konradgiero/MPPT/Dokumentacja/MPPT - Power Stage.docx

PROJEKT UKŁADU MOCY MPPT

1. PANELE SOLARNE

Jiangsu Sunport Power Co., Ltd – Benchmark II SPP310M60S

Specyfikacja:

- Maximum Power (Pmax): 310 W,
- Voltage at Maximum Power (Vmpp): 32,8 V
- Current at Maximum Power (Impp): 9,45 A
- Open Circuit Voltage (Voc): 39,9 V
- Short Circuit Current (Isc): 9,81 A
- Efficiency: 18,9 %
- Weight: 4 kg
- Dimensions: 1,66x0,99

Series Fuse Rating 15 A.

Powierzchnia: 3,2 m2

Solbian SP 144

Specyfikacja:

- Maximum Power (Pmax): 144 W,
- Voltage at Maximum Power (Vmpp): 25,3 V,
- Current at Maximum Power (Impp): 5,7 A,
- Open Circuit Voltage (Voc): 30 V,
- Short Circuit Current: 6 A,
- Weight: 1,9 kg,
- Dimensions: 1,49 x0,55

Powierzchnia: 0,82

2. NAPIĘCIA I PRĄDY WEJŚCIOWE

V_(IN(max)) =80 V

V_(IN(min)) =20 V

V_(OUT(max)) =120 V

V_(OUT(min)) =80 V

3. MAKSYMALNY PRĄD PRZEŁĄCZANIA

Panele elastyczne firmy Benchmark II SPP315M60S osiągają prąd zwarcia równy 10 A. Stąd wiemy, że maksymalny prąd cewki wynosi 10 A.

4. WARTOŚĆ INDUKCJI CEWKI

Im niższa wartość indukcji tym mniejszy rdzeń. Odpowiednią wartość indukcji obliczamy na podstawie poniższego wzoru:

ΔI_L (0.2 do 0.4)⋅I_(OUT(max)) ⋅(V_(OUT))/(V_(IN))

ΔI_L =(0.2 do 0.4)⋅9,45 A⋅(120 V)/(32,8 V)=(0.2 do 0.4)⋅34,5732 A

f_s =100 kHz

L=(V_(IN) (V_(OUT) -V_(IN) ))/(ΔI_L f_s V_(OUT))

L=(80 V(120 V-80 V))/(ΔI_L ⋅100000 Hz⋅120V)= (266,67 uH)/(ΔI_L)

Dobieramy wartość indukcji równą L=150 uH

5. GRUBOŚĆ UZWOJENIA

Maksymalny prąd cewki zakładamy 20 A. Wykorzystamy Lice nawojową w bawełnie 300x,01, średnica 2,5 mm, prąd 23 A.

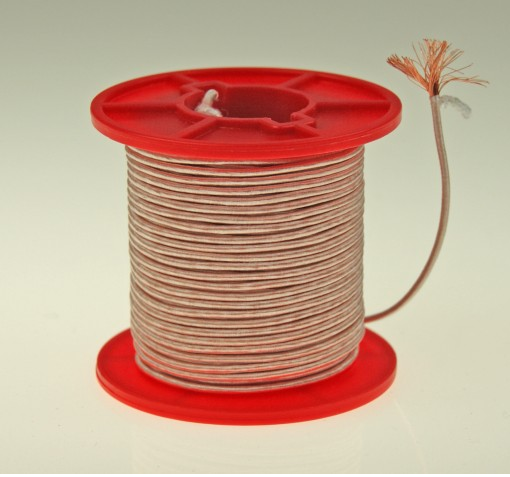
[picture p1: figure]

Rys. 5.1 Lica nawojowa

6. WZORY

W celu wyznaczenia odpowiedniego rdzenia wykorzystamy poniższe wzory.

L=A_l ⋅N^2

Prawo Ampera:

Hl=ni

H=(ni)/l

Gęstość strumienia magnetycznego:

B=(u_0 u_e ni)/l

7. RDZEŃ

Wykorzystana dwa rdzenie typu E42/21/20, jeden z gap 0 mm (B66329GX187) i drugi 1,5 mm (B66329G1500X187). Owinięto 22 razy licą i uzyskano następujące parametry statyczne:

- indukcyjność L = 102,6 uH,
- impedancja Z = 0,647 przy 1 kHz, Z = 0,0247 przy 120 Hz.
8. ZASILANIE

Załącza się przy 8,3 V i wyłącza 8,0 V -> dolny próg

Wyłącza się przy 14,4 V, załącza się przy 13,5V -> górny próg
