konradgiero/MPPT/Eagle/scheme.pdf

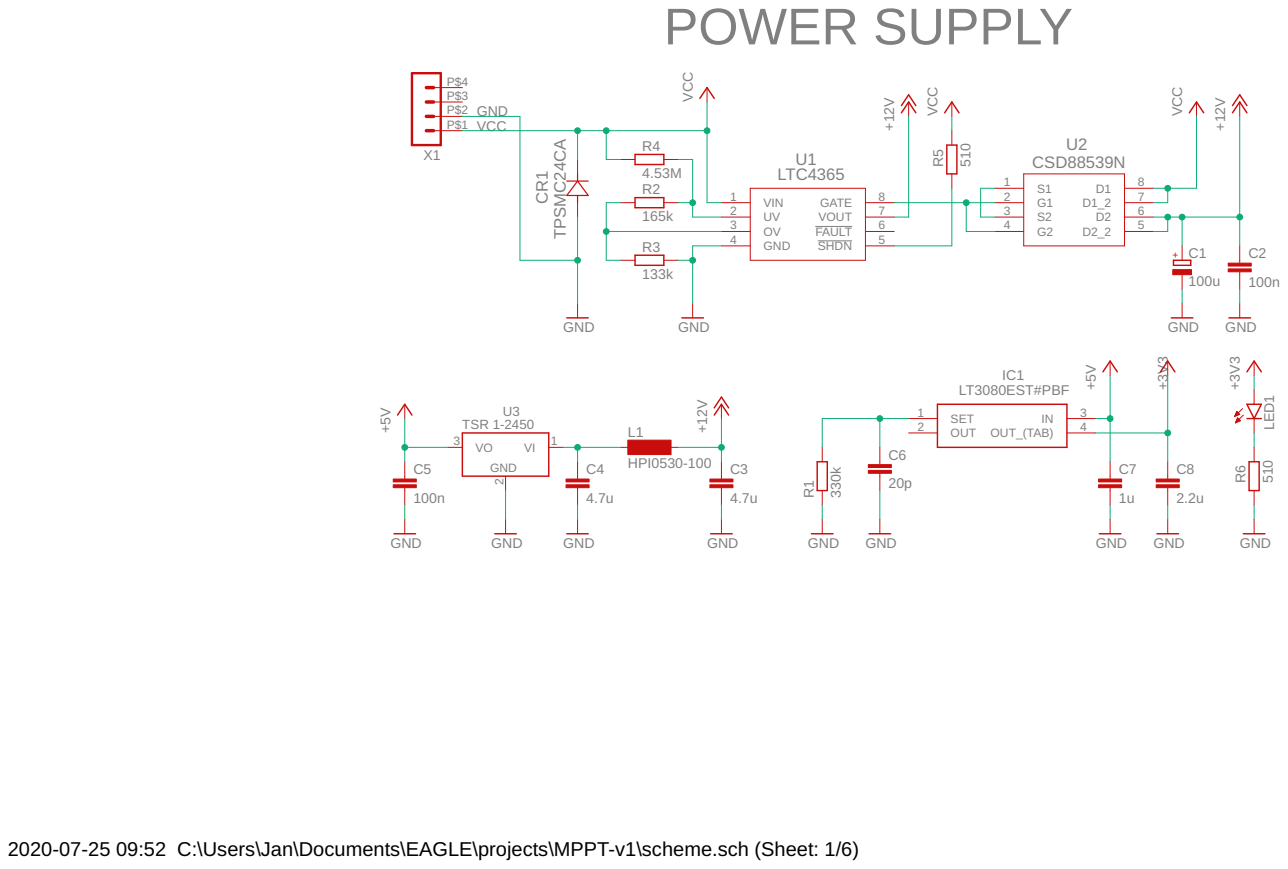
[picture p4: page 1]

2020-07-25 09:52 C:\Users\Jan\Documents\EAGLE\projects\MPPT-v1\scheme.sch (Sheet: 1/6)

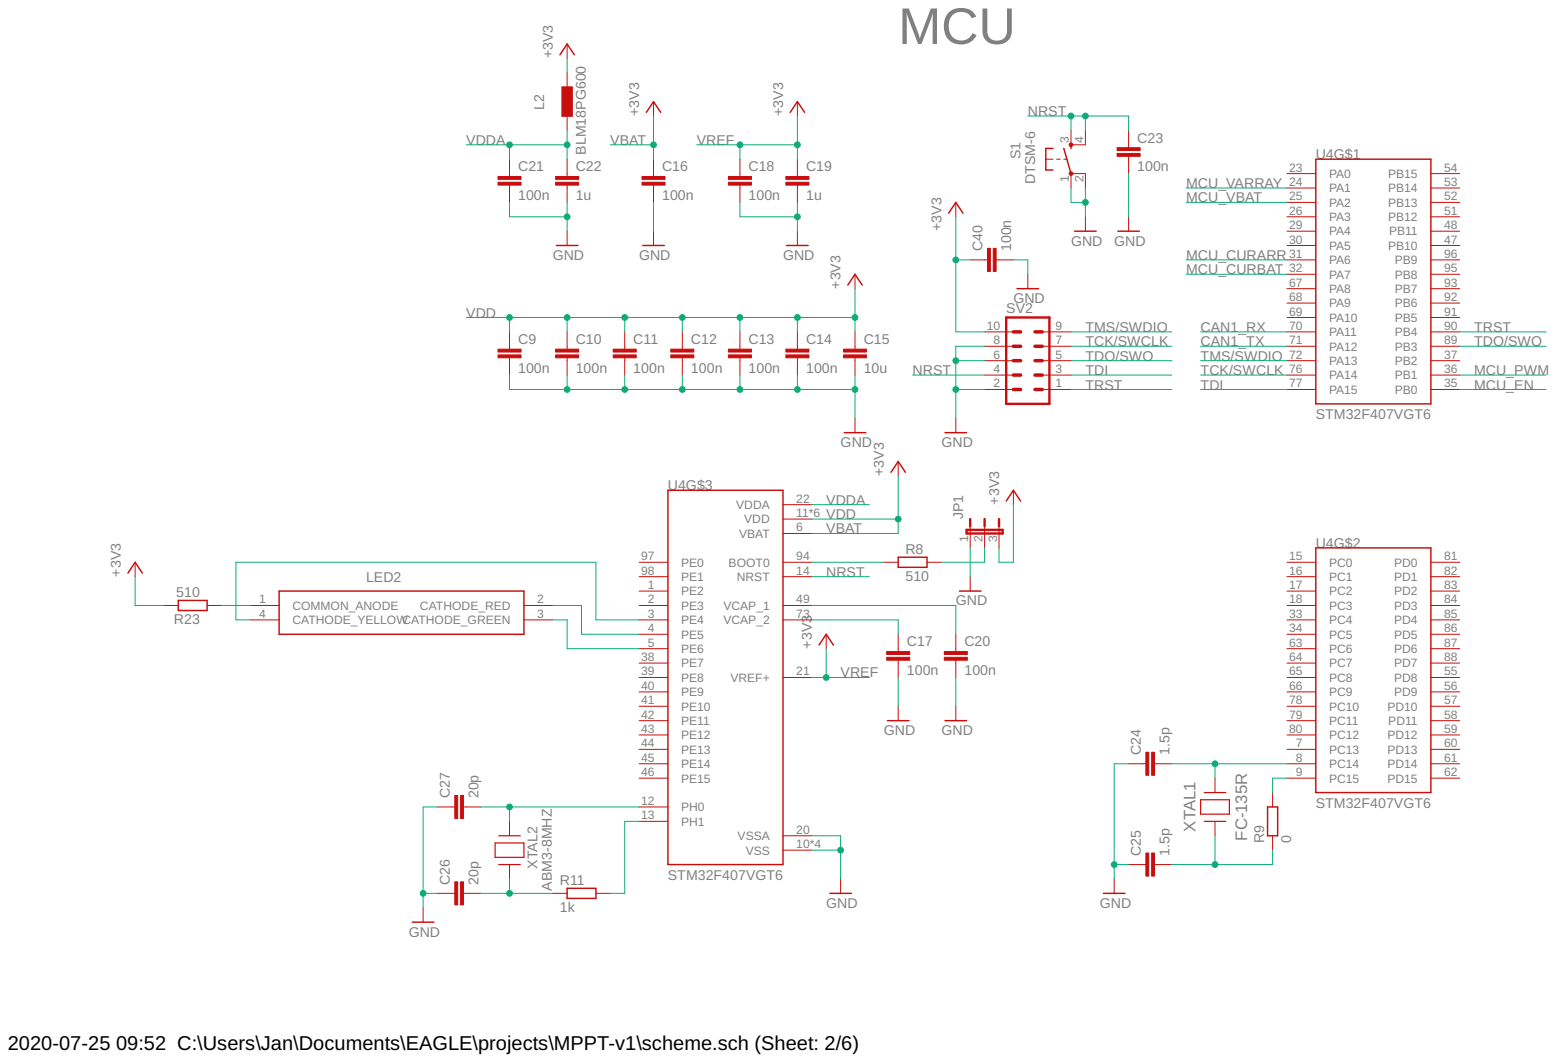
[picture p5: page 2]

2020-07-25 09:52 C:\Users\Jan\Documents\EAGLE\projects\MPPT-v1\scheme.sch (Sheet: 2/6)

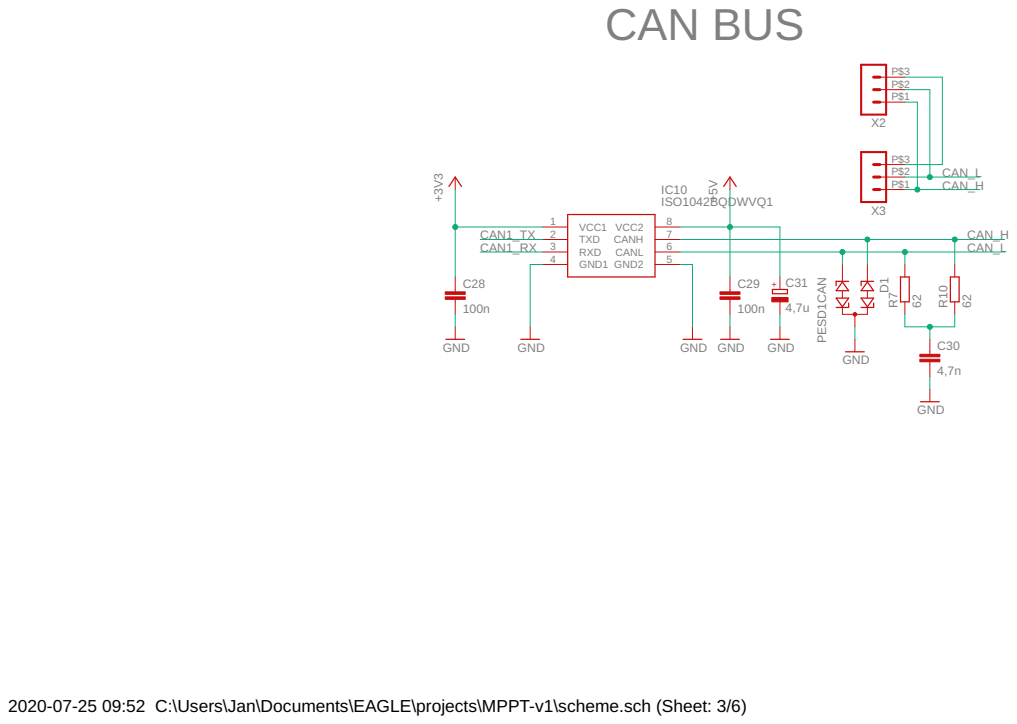
[picture p6: page 3]

2020-07-25 09:52 C:\Users\Jan\Documents\EAGLE\projects\MPPT-v1\scheme.sch (Sheet: 3/6)

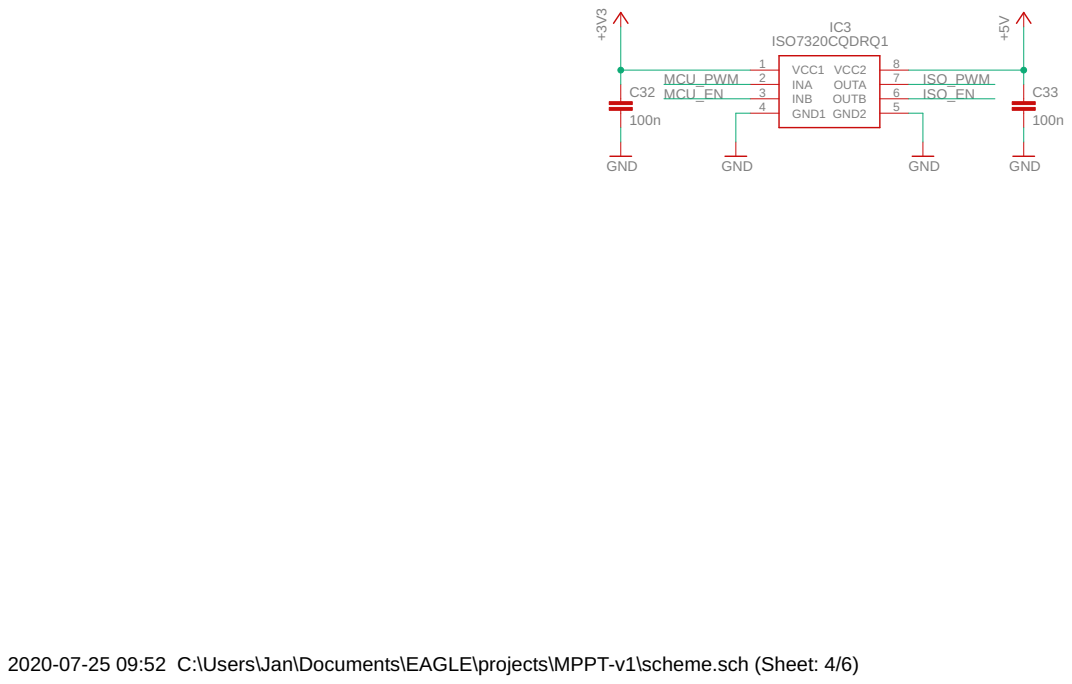
[picture p7: page 4]

2020-07-25 09:52 C:\Users\Jan\Documents\EAGLE\projects\MPPT-v1\scheme.sch (Sheet: 4/6)

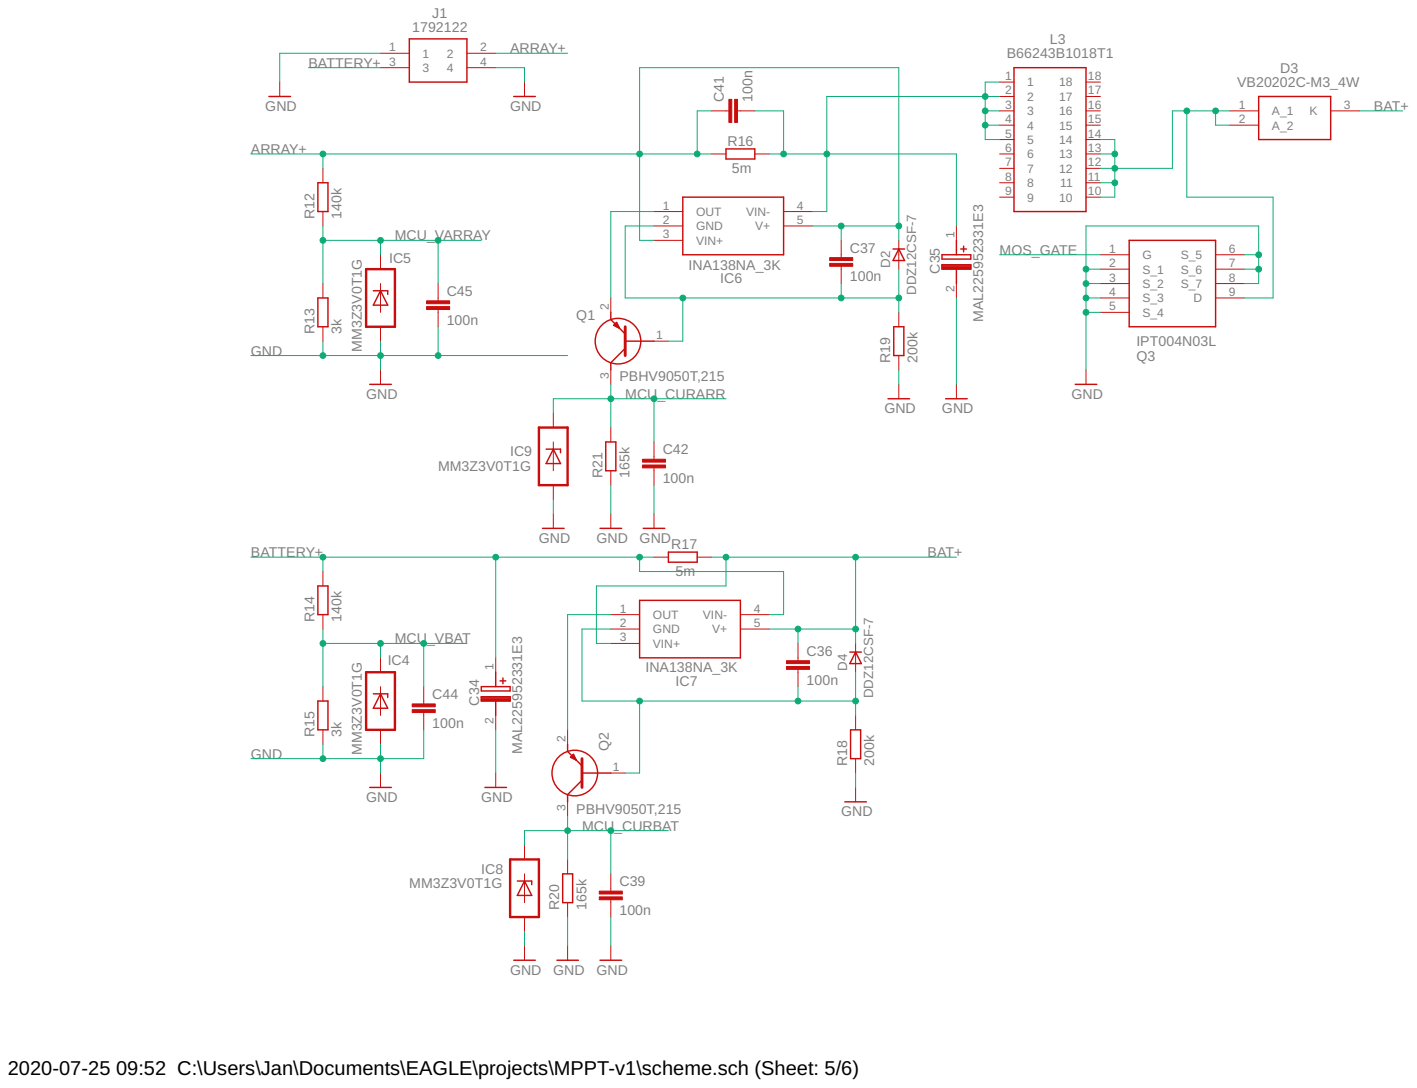
[picture p8: page 5]

2020-07-25 09:52 C:\Users\Jan\Documents\EAGLE\projects\MPPT-v1\scheme.sch (Sheet: 5/6)

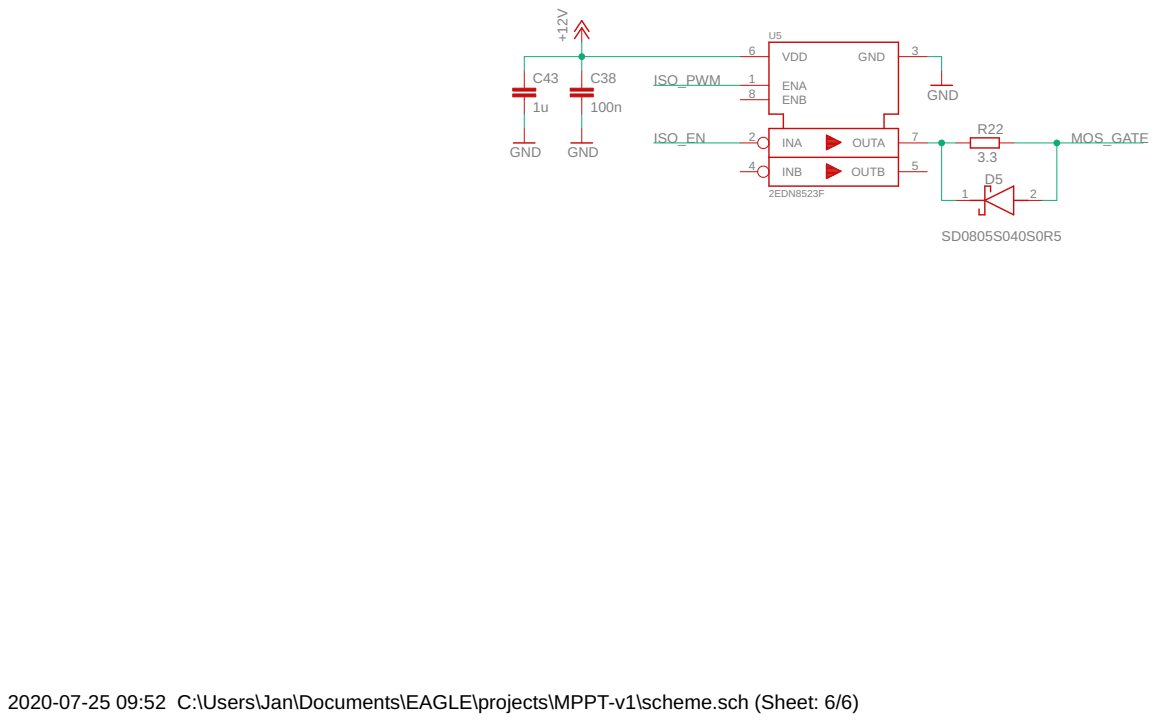
[picture p9: page 6]

2020-07-25 09:52 C:\Users\Jan\Documents\EAGLE\projects\MPPT-v1\scheme.sch (Sheet: 6/6)
