konradgiero/MPPT/LTspice_symulacja/Symulacja_MPPT.asc

C1: polcap; 330µ; V=200 Irms=3.22 Rser=0.129477 Lser=10.0366n mfg="Würth Elektronik" pn="860241081001 WCAP-AT1H 18x35,5" type="Al electrolytic"
C2: polcap; 330µ; V=200 Irms=3.22 Rser=0.129477 Lser=10.0366n mfg="Würth Elektronik" pn="860241081001 WCAP-AT1H 18x35,5" type="Al electrolytic"
C3: cap; 0.1µ; V=200 Irms=0 Rser=0.0176148 Lser=626.676p mfg="Würth Elektronik" pn="885342209002 WCAP-CSMH 1210" type="X7R"
C4: cap; 0.1µ; V=200 Irms=0 Rser=0.0176148 Lser=626.676p mfg="Würth Elektronik" pn="885342209002 WCAP-CSMH 1210" type="X7R"
C5: cap; 0.1µ; V=200 Irms=0 Rser=0.0176148 Lser=626.676p mfg="Würth Elektronik" pn="885342209002 WCAP-CSMH 1210" type="X7R"
C6: cap; 0.1µ; V=200 Irms=0 Rser=0.0176148 Lser=626.676p mfg="Würth Elektronik" pn="885342209002 WCAP-CSMH 1210" type="X7R"
D1: schottky; RB238T150
D2: diode
L1: ind; 102.6µ; Ipk=20 Rser=0.005 Rpar=0 Cpar=0
M1: nmos; AON6290
R1: res; 5m
R2: res; 5m
R3: res; 200
R4: res; 10
S1: sw
V1: voltage; 85
V2: voltage; 34
V3: voltage; PULSE(0 10 0 10n 10n 6u 10u)
V4: voltage; PULSE(12 0 100u 1n 1n 20m 21m)
Named nets: 0, Vout
.tran 100m
.model SW SW(Ron=1 Roff=1Meg Vt=.5 Vh=-.4)
