konradgiero/MPPT/Eagle/Eagle-scheme/scheme.brd

## EAGLE design Eagle/Eagle-scheme/scheme.brd (2020-08-17)

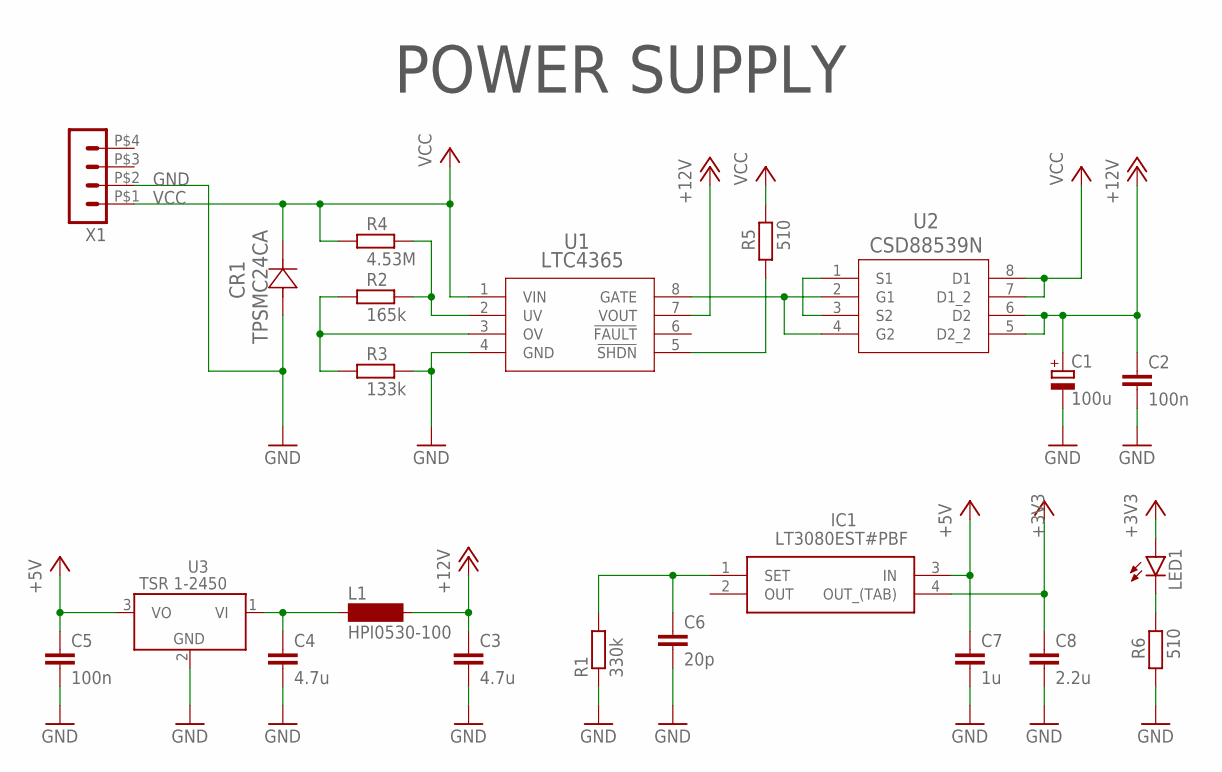
[picture p10: schematic scheme.sch, sheet 1, Power Supply]

Parts:
C1: 100u; UD-6,3X7,7_NICHICON
C2, C5: 100n; C0603K
C3, C4: 4.7u; C0805
C6: 20p; C0603K
C7: 1u; C0603
C8: 2.2u; C0603
CR1: TPSMC24CA; TPSMCSERIES-M
IC1: LT3080EST#PBF; SOT230P700X180-4N
L1: HPI0530-100; MS85
LED1: LEDCHIP-LED0805; CHIP-LED0805
R1: 330k; R0805
R2: 165k; R0603
R3: 133k; R0603
R4: 4.53M; R0603
R5, R6: 510; R0603
U1: LTC4365; TSOT-23_TS8-M
U2: CSD88539N; D8-M
U3: TSR 1-2450; TSR-1
X1: HEADER_POS4_43045-0401; 43045-0400

Connections:
+3V3: C8.1, IC1.4 (OUT_(TAB)), LED1.A; also elsewhere on the board
+5V: C5.1, C7.1, IC1.3 (IN), U3.3 (VO); also elsewhere on the board
+12V: C1.+, C2.1, C3.1, L1.2, U1.7 (VOUT), U2.5 (D2_2), U2.6 (D2); also elsewhere on the board
GND: C1.-, C2.2, C3.2, C4.2, C5.2, C6.2, C7.2, C8.2, CR1.2, R1.1, R3.1, R6.2, U1.4 (GND), U3.2 (GND), X1.P$2 (2); also elsewhere on the board
LTC_G: U1.8 (GATE), U2.2 (G1), U2.4 (G2)
unnamed: R2.1, R3.2, U1.3 (OV)
unnamed: R5.2, U1.5 (!SHDN)
unnamed: R2.2, R4.1, U1.2 (UV)
unnamed: U2.1 (S1), U2.3 (S2)
unnamed: C6.1, IC1.1 (SET), R1.2
unnamed: LED1.C, R6.1
VCC: CR1.1, R4.2, R5.1, U1.1 (VIN), U2.7 (D1_2), U2.8 (D1), X1.P$1 (1)
VI: C4.1, L1.1, U3.1 (VI)

Notes on the sheet:
POWER SUPPLY

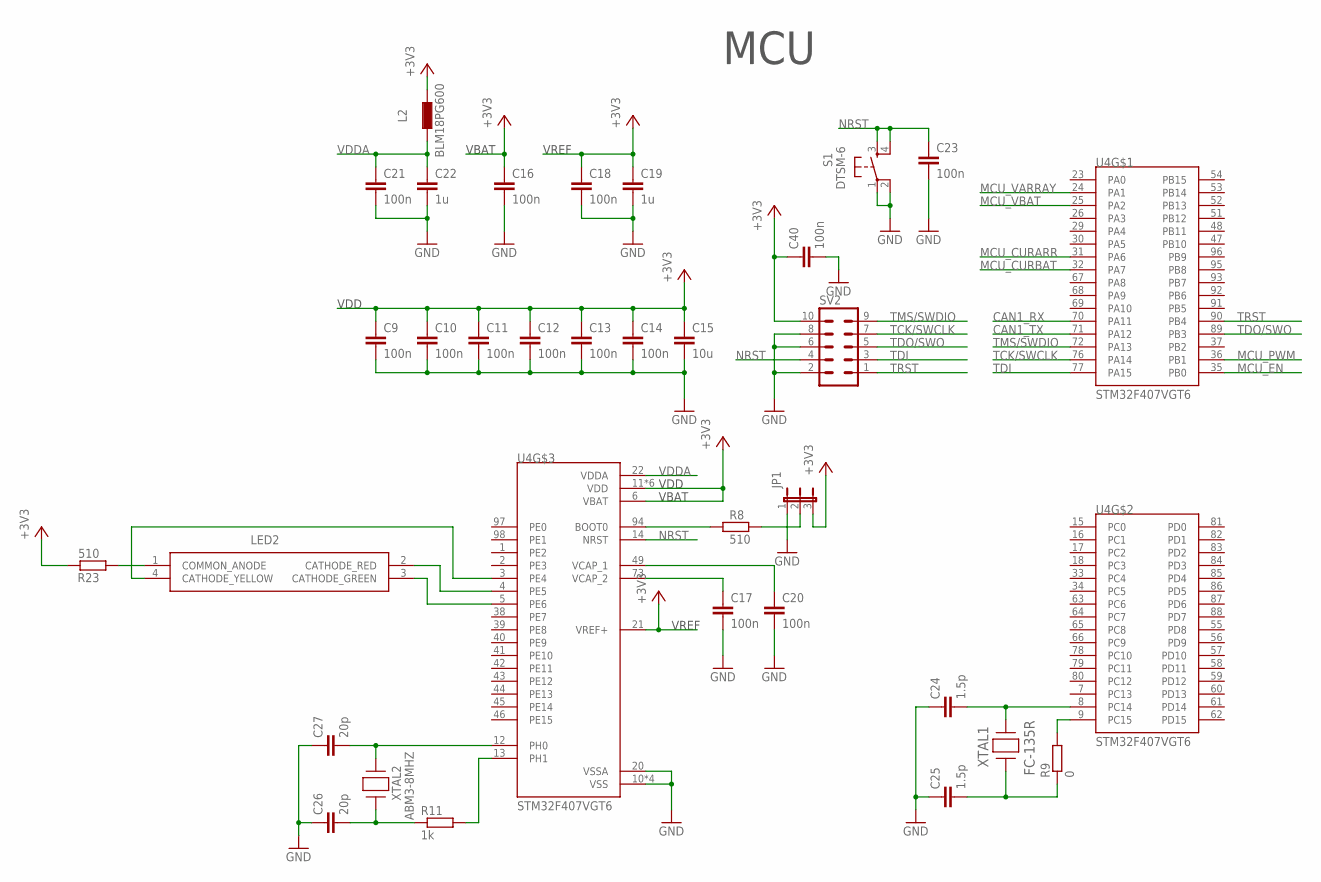
[picture p11: schematic scheme.sch, sheet 2, MCU]

Parts:
C9, C10, C11, C12, C13, C14, C16, C17, C18, C20, C21, C23: 100n; C0603K
C15: 10u; C0603K
C19, C22: 1u; C0603
C24, C25: 1.5p; C0603K
C26, C27: 20p; C0603K
C40: 100n; C0805K
JP1: JP2E; JP2
L2: BLM18PG600; L1608
LED2: APTF1616SURKCGKSYKC; KPTF1616RGBC11
R8, R23: 510; R0603
R9: 0; R0603
R11: 1k; R0603
S1: DTSM-6
SV2: ML10
U4: STM32F407VGT6; QFP50P1600X1600X160-100N
XTAL1: FC-135R; XTAL_KA-A3
XTAL2: ABM3-8MHZ; ABM38000MHZD2YT

Connections:
+3V3: C9.1, C10.1, C11.1, C12.1, C13.1, C14.1, C15.1, C16.1, C18.1, C19.1, C40.1, JP1.3, L2.2, R23.1, SV2.10, U4.6 (VBAT), U4.11 (VDD), U4.19 (VDD), U4.21 (VREF+), U4.28 (VDD), U4.50 (VDD), U4.75 (VDD), U4.100 (VDD); also elsewhere on the board
CAN1_RX: U4.70 (PA11); also elsewhere on the board
CAN1_TX: U4.71 (PA12); also elsewhere on the board
GND: C9.2, C10.2, C11.2, C12.2, C13.2, C14.2, C15.2, C16.2, C17.2, C18.2, C19.2, C20.2, C21.2, C22.2, C23.2, C24.1, C25.1, C26.1, C27.1, C40.2, JP1.1, S1.1, S1.2, SV2.2, SV2.6, SV2.8, U4.10 (VSS), U4.20 (VSSA), U4.27 (VSS), U4.74 (VSS), U4.99 (VSS); also elsewhere on the board
MCU_CURARR: U4.31 (PA6); also elsewhere on the board
MCU_CURBAT: U4.32 (PA7); also elsewhere on the board
MCU_EN: U4.35 (PB0); also elsewhere on the board
MCU_PWM: U4.36 (PB1); also elsewhere on the board
MCU_VARRAY: U4.24 (PA1); also elsewhere on the board
MCU_VBAT: U4.25 (PA2); also elsewhere on the board
unnamed: C26.2, R11.1, XTAL2.1
unnamed: C17.1, U4.73 (VCAP_2)
unnamed: C20.1, U4.49 (VCAP_1)
unnamed: R8.1, U4.94 (BOOT0)
unnamed: JP1.2, R8.2
unnamed: C25.2, R9.1, XTAL1.1
unnamed: R9.2, U4.9 (PC15)
unnamed: C24.2, U4.8 (PC14), XTAL1.2
unnamed: C27.2, U4.12 (PH0), XTAL2.2
unnamed: R11.2, U4.13 (PH1)
unnamed: LED2.1 (COMMON_ANODE), R23.2
unnamed: LED2.3 (CATHODE_GREEN), U4.5 (PE6)
unnamed: LED2.2 (CATHODE_RED), U4.4 (PE5)
unnamed: LED2.4 (CATHODE_YELLOW), U4.3 (PE4)
NRST: C23.1, S1.3, S1.4, SV2.4, U4.14 (NRST)
TCK/SWCLK: SV2.7, U4.76 (PA14)
TDI: SV2.3, U4.77 (PA15)
TDO/SWO: SV2.5, U4.89 (PB3)
TMS/SWDIO: SV2.9, U4.72 (PA13)
TRST: SV2.1, U4.90 (PB4)
VDDA: C21.1, C22.1, L2.1, U4.22 (VDDA)

Notes on the sheet:
MCU
VREF
VDD
VBAT

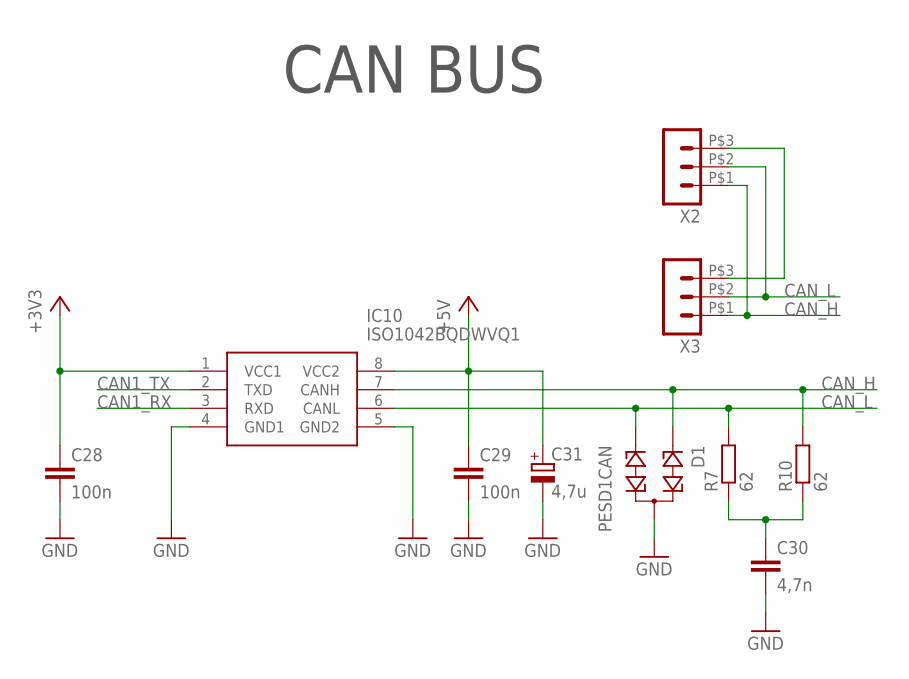
[picture p12: schematic scheme.sch, sheet 3, CAN Bus]

Parts:
C28, C29: 100n; C0603K
C30: 4,7n; C0603K
C31: 4,7u; UD-4X5,8_NICHICON
D1: PESD1CAN; SOT23
IC10: ISO1042BQDWVQ1; SOIC127P1150X280-8N
R7, R10: 62; R0603
X2, X3: HEADER_POS3_43650-0300; 43650-0300

Connections:
+3V3: C28.1, IC10.1 (VCC1); also elsewhere on the board
+5V: C29.1, C31.+, IC10.8 (VCC2); also elsewhere on the board
CAN1_RX: IC10.3 (RXD); also elsewhere on the board
CAN1_TX: IC10.2 (TXD); also elsewhere on the board
CAN_H: D1.1, IC10.7 (CANH), R10.2, X2.P$1 (1), X3.P$1 (1)
CAN_L: D1.2, IC10.6 (CANL), R7.2, X2.P$2 (2), X3.P$2 (2)
GND: C28.2, C29.2, C30.2, C31.-, D1.3, IC10.4 (GND1); also elsewhere on the board
unnamed: C30.1, R7.1, R10.1
unnamed: X2.P$3 (3), X3.P$3 (3)

Notes on the sheet:
CAN BUS

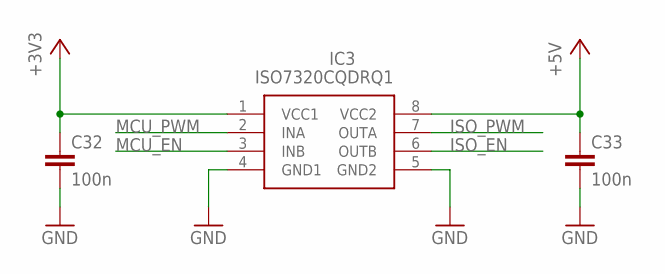
[picture p13: schematic scheme.sch, sheet 4, GPIO Isolator]

Parts:
C32, C33: 100n; C0603K
IC3: ISO7320CQDRQ1; SOIC127P600X175-8N

Connections:
+3V3: C32.1, IC3.1 (VCC1); also elsewhere on the board
+5V: C33.1, IC3.8 (VCC2); also elsewhere on the board
GND: C32.2, C33.2, IC3.4 (GND1), IC3.5 (GND2); also elsewhere on the board
ISO_EN: IC3.6 (OUTB); also elsewhere on the board
ISO_PWM: IC3.7 (OUTA); also elsewhere on the board
MCU_EN: IC3.3 (INB); also elsewhere on the board
MCU_PWM: IC3.2 (INA); also elsewhere on the board

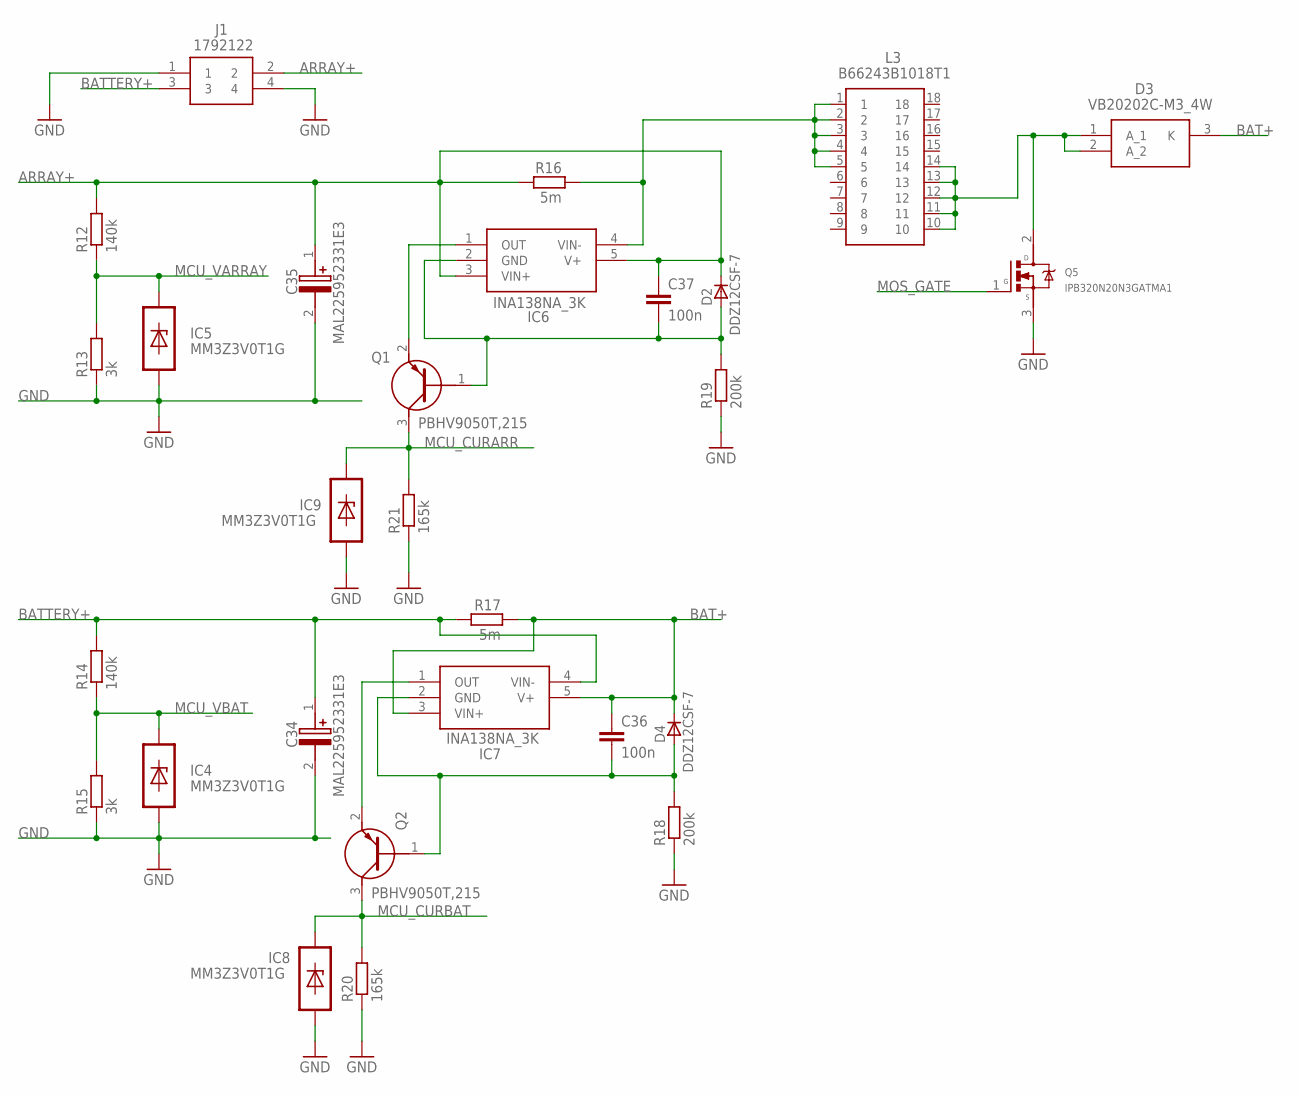
[picture p14: schematic scheme.sch, sheet 5, MPPT Power Stage]

Parts:
C34, C35: MAL225952331E3; CAPPRD1000W200D2200H3000
C36, C37: 100n; C0603K
D2, D4: DDZ12CSF-7; SOD323F
D3: VB20202C-M3_4W; VB20202CM34W
IC4, IC5, IC8, IC9: MM3Z3V0T1G; SOD323
IC6, IC7: INA138NA_3K; SOT95P280X145-5N
J1: 1792122
L3: B66243B1018T1; DIPS2750W100P500L4600H4140Q18N
Q1, Q2: PBHV9050T,215; SOT95P230X110-3N
Q5: IPB320N20N3GATMA1; DPAK508P1524X483-3N
R12, R14: 140k; R0603
R13, R15: 3k; R0603
R16, R17: 5m; R2512
R18, R19: 200k; R0805
R20, R21: 165k; R0805

Connections:
ARRAY+: C35.1 (+), C37.1, D2.C, IC6.3 (VIN+), IC6.5 (V+), J1.2, R12.2, R16.1
BAT+: C36.1, D3.3 (K), D4.C, IC7.3 (VIN+), IC7.5 (V+), R17.2
BATTERY+: C34.1 (+), IC7.4 (VIN-), J1.3, R14.2, R17.1
GND: C34.2 (-), C35.2 (-), IC4.2, IC5.2, IC8.2, IC9.2, J1.1, J1.4, Q5.3 (S), R13.1, R15.1, R18.1, R19.1, R20.1, R21.1; also elsewhere on the board
MCU_CURARR: IC9.1, Q1.3 (C), R21.2; also elsewhere on the board
MCU_CURBAT: IC8.1, Q2.3 (C), R20.2; also elsewhere on the board
MCU_VARRAY: IC5.1, R12.1, R13.2; also elsewhere on the board
MCU_VBAT: IC4.1, R14.1, R15.2; also elsewhere on the board
MOS_GATE: Q5.1 (G); also elsewhere on the board
unnamed: IC6.4 (VIN-), L3.1, L3.2, L3.3, L3.4, L3.5, R16.2
unnamed: D3.1 (A_1), D3.2 (A_2), L3.10, L3.11, L3.12, L3.13, L3.14, Q5.2 (D)
unnamed: IC7.1 (OUT), Q2.2 (E)
unnamed: IC6.1 (OUT), Q1.2 (E)
unnamed: C36.2, D4.A, IC7.2 (GND), Q2.1 (B), R18.2
unnamed: C37.2, D2.A, IC6.2 (GND), Q1.1 (B), R19.2

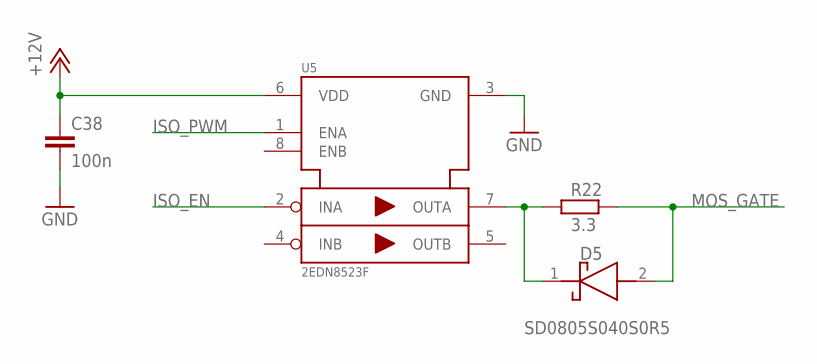
[picture p15: schematic scheme.sch, sheet 6, MOSFET DRIVER]

Parts:
C38: 100n; C0603K
D5: SD0805S040S0R5; SD0805
R22: 3.3; R0805
U5: 2EDN8523F; SOIC127P602X173-8N-V

Connections:
+12V: C38.1, U5.6 (VDD); also elsewhere on the board
GND: C38.2, U5.3 (GND); also elsewhere on the board
ISO_EN: U5.2 (INA); also elsewhere on the board
ISO_PWM: U5.1 (ENA); also elsewhere on the board
MOS_GATE: D5.2 (A), R22.2; also elsewhere on the board
unnamed: D5.1 (K), R22.1, U5.7 (OUTA)

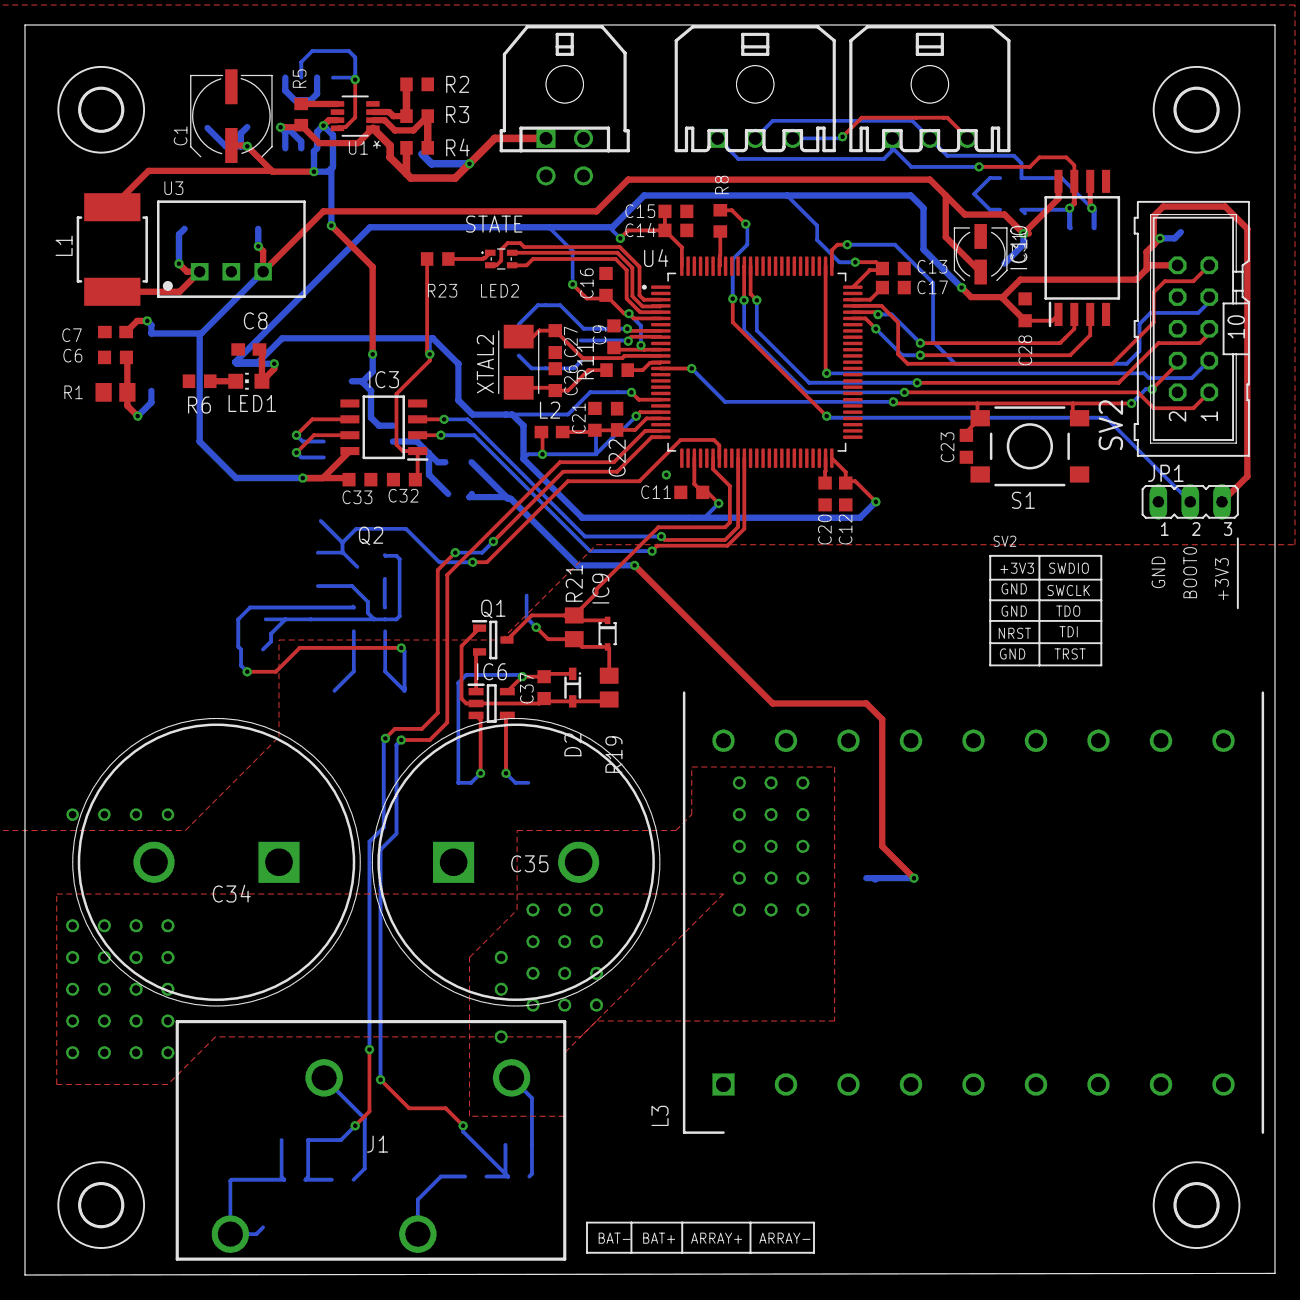
[picture p16: board scheme.brd from above]

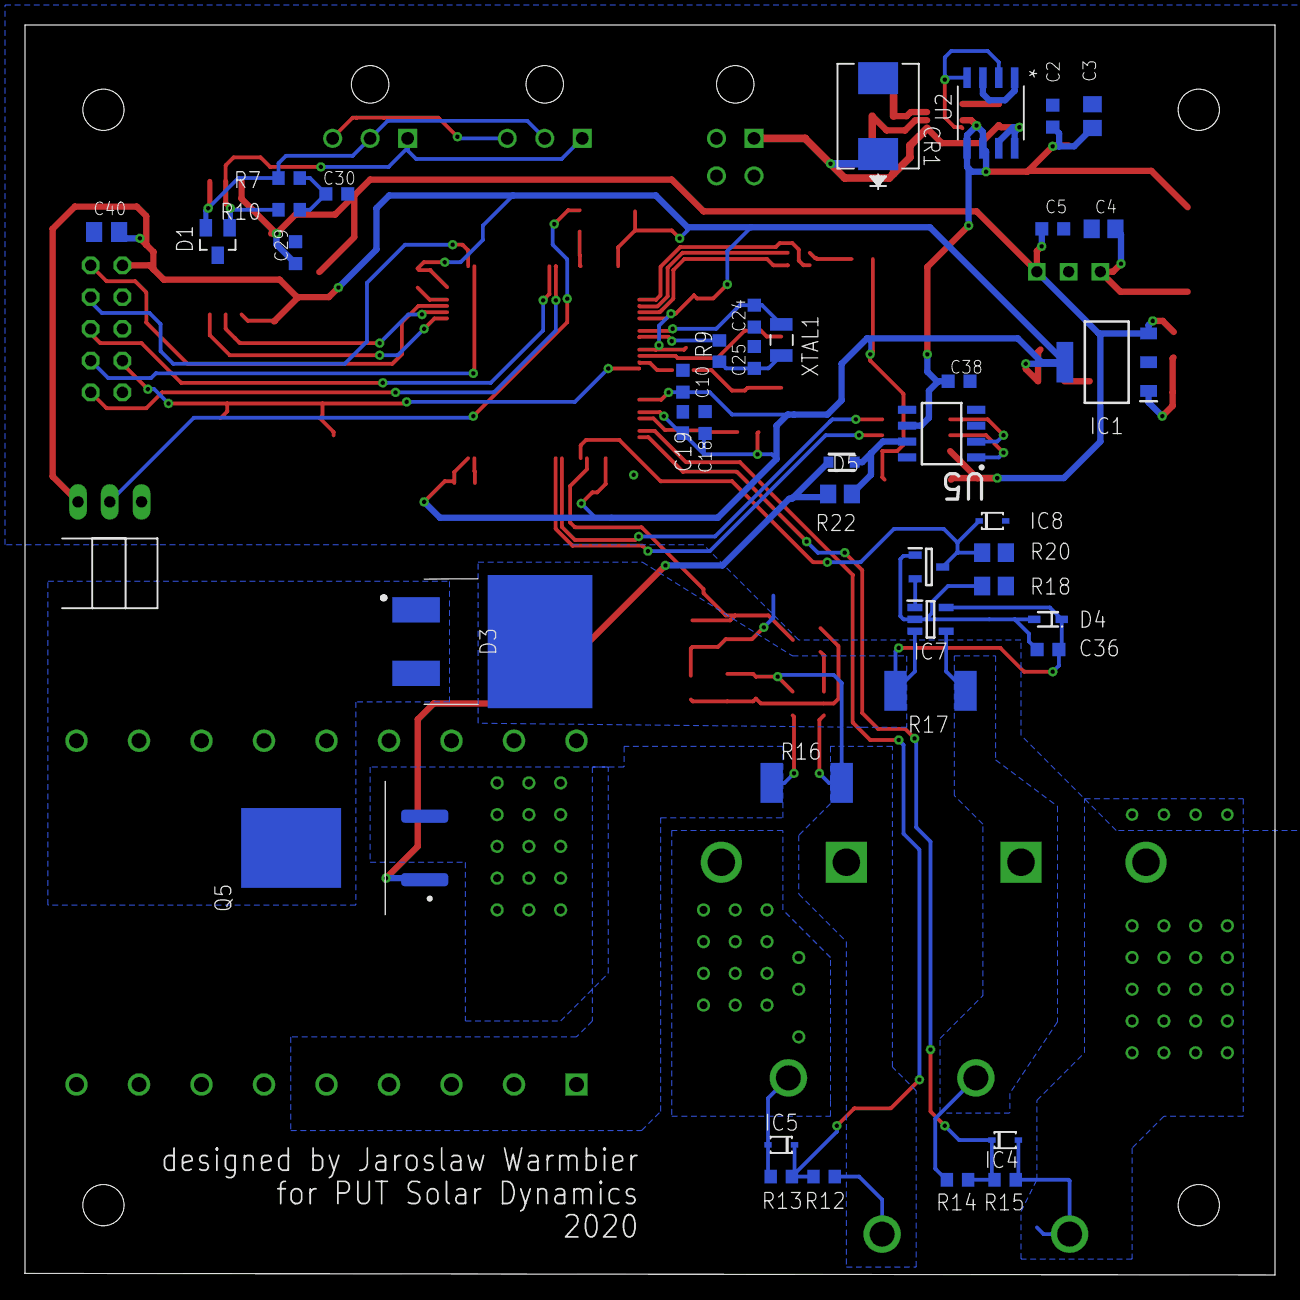
[picture p17: board scheme.brd from below]

Board: 2 copper layers, 100.0 x 100.0 mm, 103 parts (41 on the bottom side), 59 nets.

Other parts of the board:
U$1, U$2, U$3, U$4: 3,3
