konradgiero/MPPT/MPPT-V_1_0/Src/main.c

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
/* Includes ------------------------------------------------------------------*/
#include "main.h"
#include "adc.h"
#include "can.h"
#include "dma.h"
#include "tim.h"
#include "gpio.h"

/* USER CODE BEGIN Includes */
#include "utilities.h"
/* USER CODE END Includes */


void SystemClock_Config(void);
/**
  * @brief  The application entry point.
  * @retval int
  */
int main(void)
{
  /* USER CODE BEGIN 1 */
	isMPPTInitialised = 0;
  /* USER CODE END 1 */

  /* MCU Configuration--------------------------------------------------------*/

  /* Reset of all peripherals, Initializes the Flash interface and the Systick. */
  HAL_Init();

  /* Configure the system clock */
  SystemClock_Config();

  /* Initialize all configured peripherals */
  MX_GPIO_Init();
  MX_DMA_Init();
  MX_TIM3_Init();
  MX_ADC1_Init();
  MX_CAN1_Init();
  MX_TIM2_Init();
  MX_TIM1_Init();
  MX_TIM4_Init();
  /* USER CODE BEGIN 2 */

  CANFilerConfig();
  CAN1_Init();

  HAL_TIM_PWM_Start(&htim3, TIM_CHANNEL_4); 			//MCU_PWM
  HAL_GPIO_WritePin(GPIOB, GPIO_PIN_0, GPIO_PIN_SET);	//MCU_PWM_EN Register


  HAL_TIM_Base_Start_IT(&htim4);
  HAL_TIM_Base_Start_IT(&htim1);

  MPPTInit();

  enablePWM();
  /* USER CODE END 2 */

  /* Infinite loop */
  /* USER CODE BEGIN WHILE */

  while (1)
  {
	  storeMeasurements();
	  HAL_Delay(DELAY_BETWEEN_MEASUREMENTS);
	  sendCANData(0x1, 0x2, 0x3, 0x4, 0x5, 0x6, 0x7, 0x8);
	  HAL_Delay(1000);


    /* USER CODE END WHILE */

    /* USER CODE BEGIN 3 */

  }
  /* USER CODE END 3 */
}

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
/* USER CODE BEGIN 4 */
void HAL_TIM_PeriodElapsedCallback(TIM_HandleTypeDef *htim)
{
	if(isMPPTInitialised)
	{
		if(htim->Instance == TIM1) // T = 1 s*/
		{
			sendCAN();
		}

		if(htim->Instance == TIM4) // T = 500ms
		{
			checkArrayConnection();
			//checkBatteryConnection();

			if(MPPTState == MPPT_STATE_GREEN)
			{
				void PandOAlgorithm();
			}
		}
	}
}

void PandOAlgorithm(void)
{
	uint32_t prevPowerValue = inputPower;
	calculateInputPower();

	if (prevStepDirection == STEP_UP)
	{
		if (inputPower > prevPowerValue)
			increaseDutyCycle();
		else
			decreaseDutyCycle();
	}

	if(prevStepDirection == STEP_DOWN)
	{
		if (inputPower > prevPowerValue)
			decreaseDutyCycle();
		else
			increaseDutyCycle();
	}
}

/* USER CODE END 4 */
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
