konradgiero/MPPT/MPPT-V_1_0/MPPT-V_1_0.ioc

Mcu.UserName=STM32F407VGTx
PA1.Signal=ADCx_IN1
PA11.Signal=CAN1_RX
PA12.Signal=CAN1_TX
PA2.Signal=ADCx_IN2
PA6.Signal=ADCx_IN6
PA7.Signal=ADCx_IN7
PB0.Signal=GPIO_Output
PB1.Signal=S_TIM3_CH4
PC14-OSC32_IN.Signal=RCC_OSC32_IN
PC15-OSC32_OUT.Signal=RCC_OSC32_OUT
PE4.Signal=GPIO_Output
PE5.Signal=GPIO_Output
PE6.Signal=GPIO_Output
PH0-OSC_IN.Signal=RCC_OSC_IN
PH1-OSC_OUT.Signal=RCC_OSC_OUT
