konradgiero/MPPT/MPPT-V_1_0/Inc/can.h

/**
  ******************************************************************************
  * @file    can.h
  * @brief   This file contains all the function prototypes for
  *          the can.c file
  ******************************************************************************
  * @attention
  *
  * <h2><center>&copy; Copyright (c) 2021 STMicroelectronics.
  * All rights reserved.</center></h2>
  *
  * This software component is licensed by ST under BSD 3-Clause license,
  * the "License"; You may not use this file except in compliance with the
  * License. You may obtain a copy of the License at:
  *                        opensource.org/licenses/BSD-3-Clause
  *
  ******************************************************************************
  */
/* Define to prevent recursive inclusion -------------------------------------*/
#ifndef __CAN_H__
#define __CAN_H__

#ifdef __cplusplus
extern "C" {
#endif

/* Includes ------------------------------------------------------------------*/
#include "main.h"

extern CAN_HandleTypeDef hcan1;

/* USER CODE BEGIN Private defines */

CAN_FilterTypeDef	filter_0;
void CAN1_Init(void);
void sendCAN(void);
void CANFilerConfig(void);
void prepareFrameData(void);
void sendCANData(uint8_t byte0, uint8_t byte1, uint8_t byte2, uint8_t byte3, uint8_t byte4, uint8_t byte5, uint8_t byte6, uint8_t byte7);

typedef struct
	{
		uint8_t 				TxData[8];
		CAN_TxHeaderTypeDef		TxHeader;
		uint8_t 				RxData[8];
	}CAN_FrameInit;
/* USER CODE END Private defines */

void MX_CAN1_Init(void);

#ifdef __cplusplus
}
#endif

#endif /* __CAN_H__ */

/************************ (C) COPYRIGHT STMicroelectronics *****END OF FILE****/
