konradgiero/MPPT/(commit log)

2020-08-14 revert removed metadata directory
    [MPPT-V_1_0.ioc, main.c]
2020-08-14 added led state control functions
2020-08-17 added datasheet in polish
    [Inductor.xlsx, scheme.brd, scheme.sch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]
2021-08-21 Experiment with gitignore
    [MPPT-V_1_0.elf.cfg]
