konradgiero/MPPT/(notices)

Notices in the files:
MPPT-V_1_0/Src/main.c:
© Copyright (c) 2020 STMicroelectronics.
All rights reserved.
parts and their libraries:
COPYRIGHT: Copyright (C) 2018 Accelerated Designs. All rights reserved
